nfernoedge/Badge-Preprototype/First Prototype/Initial BOM.xlsx

Schematic # | Rating | Cost | #/board | Part amount for 100 | Cost for 1 | Cost for 100 (10% over) | Notes | Link to part
C1-C3, C6-C7 | 100n | $0.06 | 5 | 500 | $0.29 | $31.90 | Rated 50VDC | https://www.mouser.com/ProductDetail/KYOCERA-AVX/08055C104M4T4A?qs=xMTsDkQFXIy%252BVvJLAuiCrA%3D%3D
C4 | 47n | $0.23 | 1 | 100 | $0.23 | $25.30 | Rated 500VDC, this may be change | https://www.mouser.com/ProductDetail/Vishay-BC-Components/D472M33Z5UL6UJ5R
C5 | 100u | $0.12 | 1 | 100 | $0.12 | $13.53 | Rated 10VDC? | https://www.mouser.com/ProductDetail/Panasonic/EEU-FR1A101B?qs=sGAEpiMZZMvwFf0viD3Y3aIPvi3NCL4PziGmoV7SQrs%3D
D1 | 3v3 | $0.13 | 1 | 100 | $0.13 | $13.97 |  | https://www.mouser.com/ProductDetail/Diotec-Semiconductor/BZT52C3V3?qs=OlC7AqGiEDmtA8GX4QnKtA%3D%3D
D2 | MUR160 | $0.20 | 1 | 100 | $0.20 | $21.78 |  | https://www.mouser.com/ProductDetail/Diodes-Incorporated/MUR160?qs=7ctcZc7ShisDdGkSVd5tIw%3D%3D
D3, D4 | 200v | $0.26 | 2 | 200 | $0.52 | $57.20 | Confirm pads | https://www.mouser.com/ProductDetail/Diodes-Incorporated/1SMB5956B-13?qs=uwKJARvjadOTUcHkJGZGig%3D%3D
D5 | 1n4148 | $0.04 | 1 | 100 | $0.04 | $4.95 | Confirm correct diode | https://www.mouser.com/ProductDetail/Diotec-Semiconductor/1N4148?qs=OlC7AqGiEDmWf1%2FPHy84oA%3D%3D
L1 | 10m | $0.22 | 1 | 100 | $0.22 | $24.64 |  | https://www.mouser.com/ProductDetail/Bourns/RLB0812-103KL
Q1 | MPSA44 | $0.24 | 1 | 100 | $0.24 | $26.40 | See second link need heavy advice | https://www.mouser.com/ProductDetail/Diotec-Semiconductor/MPSA44 | https://www.digikey.com/en/products/detail/bourns-inc./RLB0913-103K/6677245
Q2 | BC328 | $0.14 | 1 | 100 | $0.14 | $15.07 |  | https://www.mouser.com/ProductDetail/Diotec-Semiconductor/BC328-16?qs=OlC7AqGiEDnRu3DZnYROLw%3D%3D
Q3 | BC517 | $0.23 | 1 | 100 | $0.23 | $25.08 | Seems rare | https://www.mouser.com/ProductDetail/onsemi-Fairchild/BC517-D74Z?qs=0lQeLiL1qybcgMwglWXoEw%3D%3D
R1 | 3k3 | $0.01 | 1 | 100 | $0.01 | $1.32 | Specs? | https://www.mouser.com/ProductDetail/TE-Connectivity-Holsworthy/CRG0805F3K3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
R2 | 1k5 | $0.04 | 1 | 100 | $0.04 | $3.85 | Specs? | https://www.mouser.com/ProductDetail/Vishay-Dale/CRCW08051K50FKEAHP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
R3 | 15 | $0.06 | 1 | 100 | $0.06 | $6.27 | Specs? | https://www.mouser.com/ProductDetail/ROHM-Semiconductor/SFR10EZPF15R0
R4, R11 | 10k | $0.10 | 2 | 200 | $0.19 | $20.90 | Specs? | https://www.mouser.com/ProductDetail/Vishay-Dale/TNPW080510K0DEEA?qs=dafR6q3Fy0zPpQJxxOiriQ%3D%3D
R5, R10 | 100k | $0.04 | 2 | 200 | $0.08 | $9.02 | Specs? | https://www.mouser.com/ProductDetail/Vishay-Dale/RCC0805100KFKEA
R6-R8 | 1M8 | $0.07 | 3 | 300 | $0.22 | $24.42 | Specs? Voltage? | https://www.mouser.com/ProductDetail/ROHM-Semiconductor/SDR10EZPJ185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
R9 | 220k | $0.07 | 1 | 100 | $0.07 | $8.03 | Specs? | https://www.mouser.com/ProductDetail/Panasonic/ERJ-PB6B2203V?qs=sGAEpiMZZMtlubZbdhIBIMNI7sOfyRuJsIHuhHWPNXI%3D
R12 | 3k9 | $0.07 | 1 | 100 | $0.07 | $8.25 | Specs? | https://www.mouser.com/ProductDetail/Panasonic/ERA-6AED392V
U1, U2 | TLC555xP | $0.61 | 2 | 200 | $1.23 | $134.86 | Correct? SMD? Jumper? | https://www.mouser.com/ProductDetail/Texas-Instruments/TLC555CP?qs=gb35HGp1gQKr83Vf%252BmVC1w%3D%3D
Geiger Tube Clips |  | $0.10 | 2 | 200 | $0.20 | $22.44 | Size thoughts? | https://www.mouser.com/ProductDetail/Littelfuse/01110501Z?qs=Ql%252B1sS8nYriZVK%2FyEjYMGg%3D%3D
Geiger Tube | J302 | $19.50 | 1 | 100 | $19.50 | $2145.00 | Shipping Negotiated | https://www.alibaba.com/product-detail/Geiger-Muller-Tube-Glass-case-J302_1600898358443.html
Board | PCBWAY | $8.90 | 1 | 100 | $8.90 | $890.00 | $150 for 4 board; likely to rise with customization
 |  |  | Total Cost: |  | $32.94 | $3534.18
 |  |  | Assumptions: Minimum order of 100 boards for mouser pricing; doesn't include any LED flashing lights, might raise price $1-2, also doesn't include standoff/polycarb/protection
 |  |  |  |  | Without Tubes | $1389.18
