nfernoedge/Badge-Preprototype/First Prototype/schematic.pdf

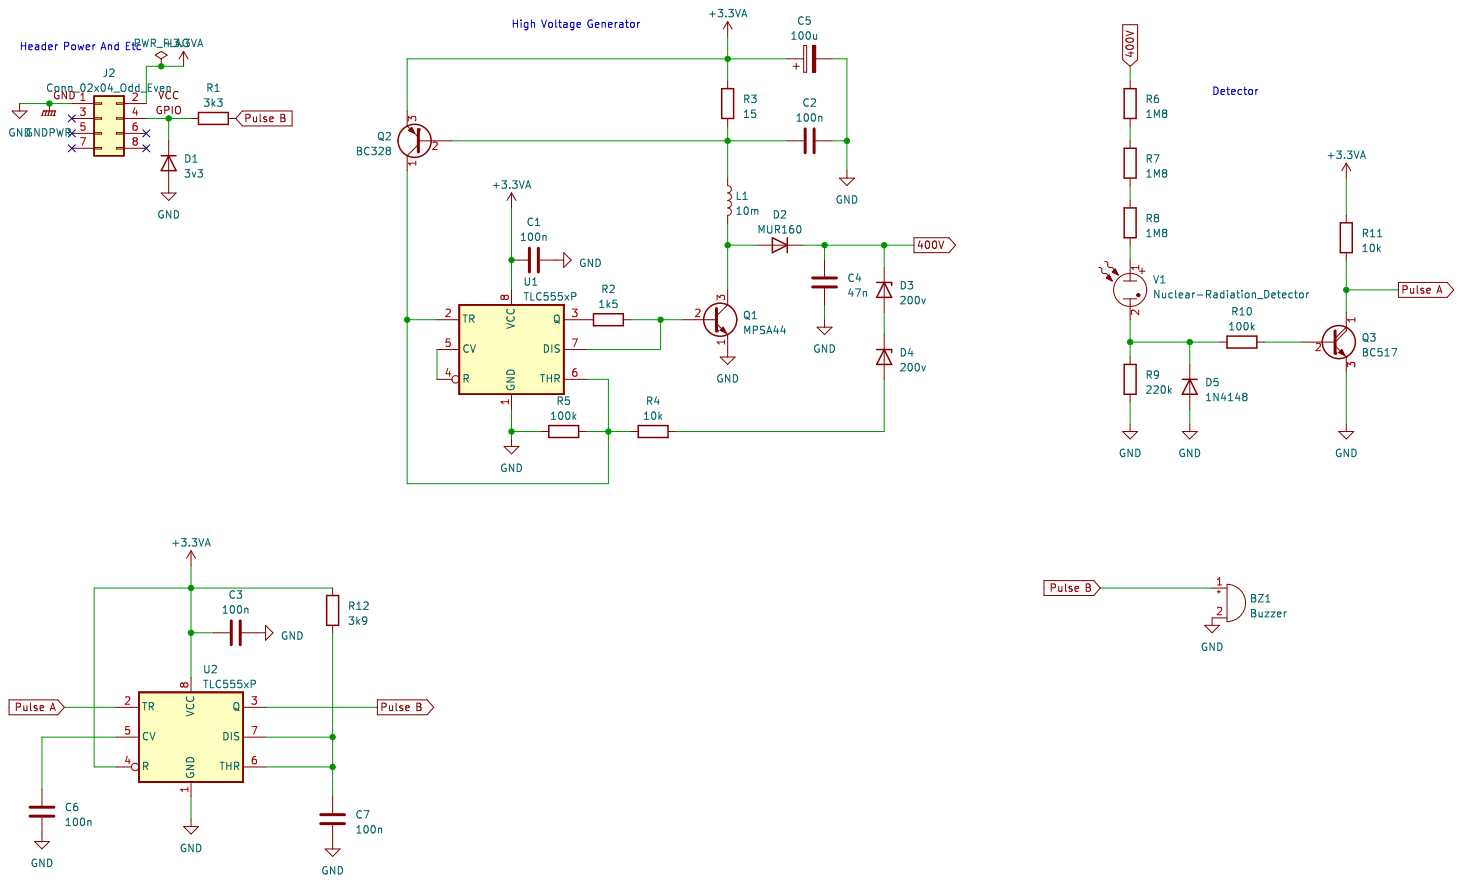
[picture p2: page 1]
