nfernoedge/Badge-Preprototype/First Prototype/Initial Build/Initial Build.kicad_pcb

## KiCad design First Prototype/Initial Build/Initial Build.kicad_pcb (2023-10-23)

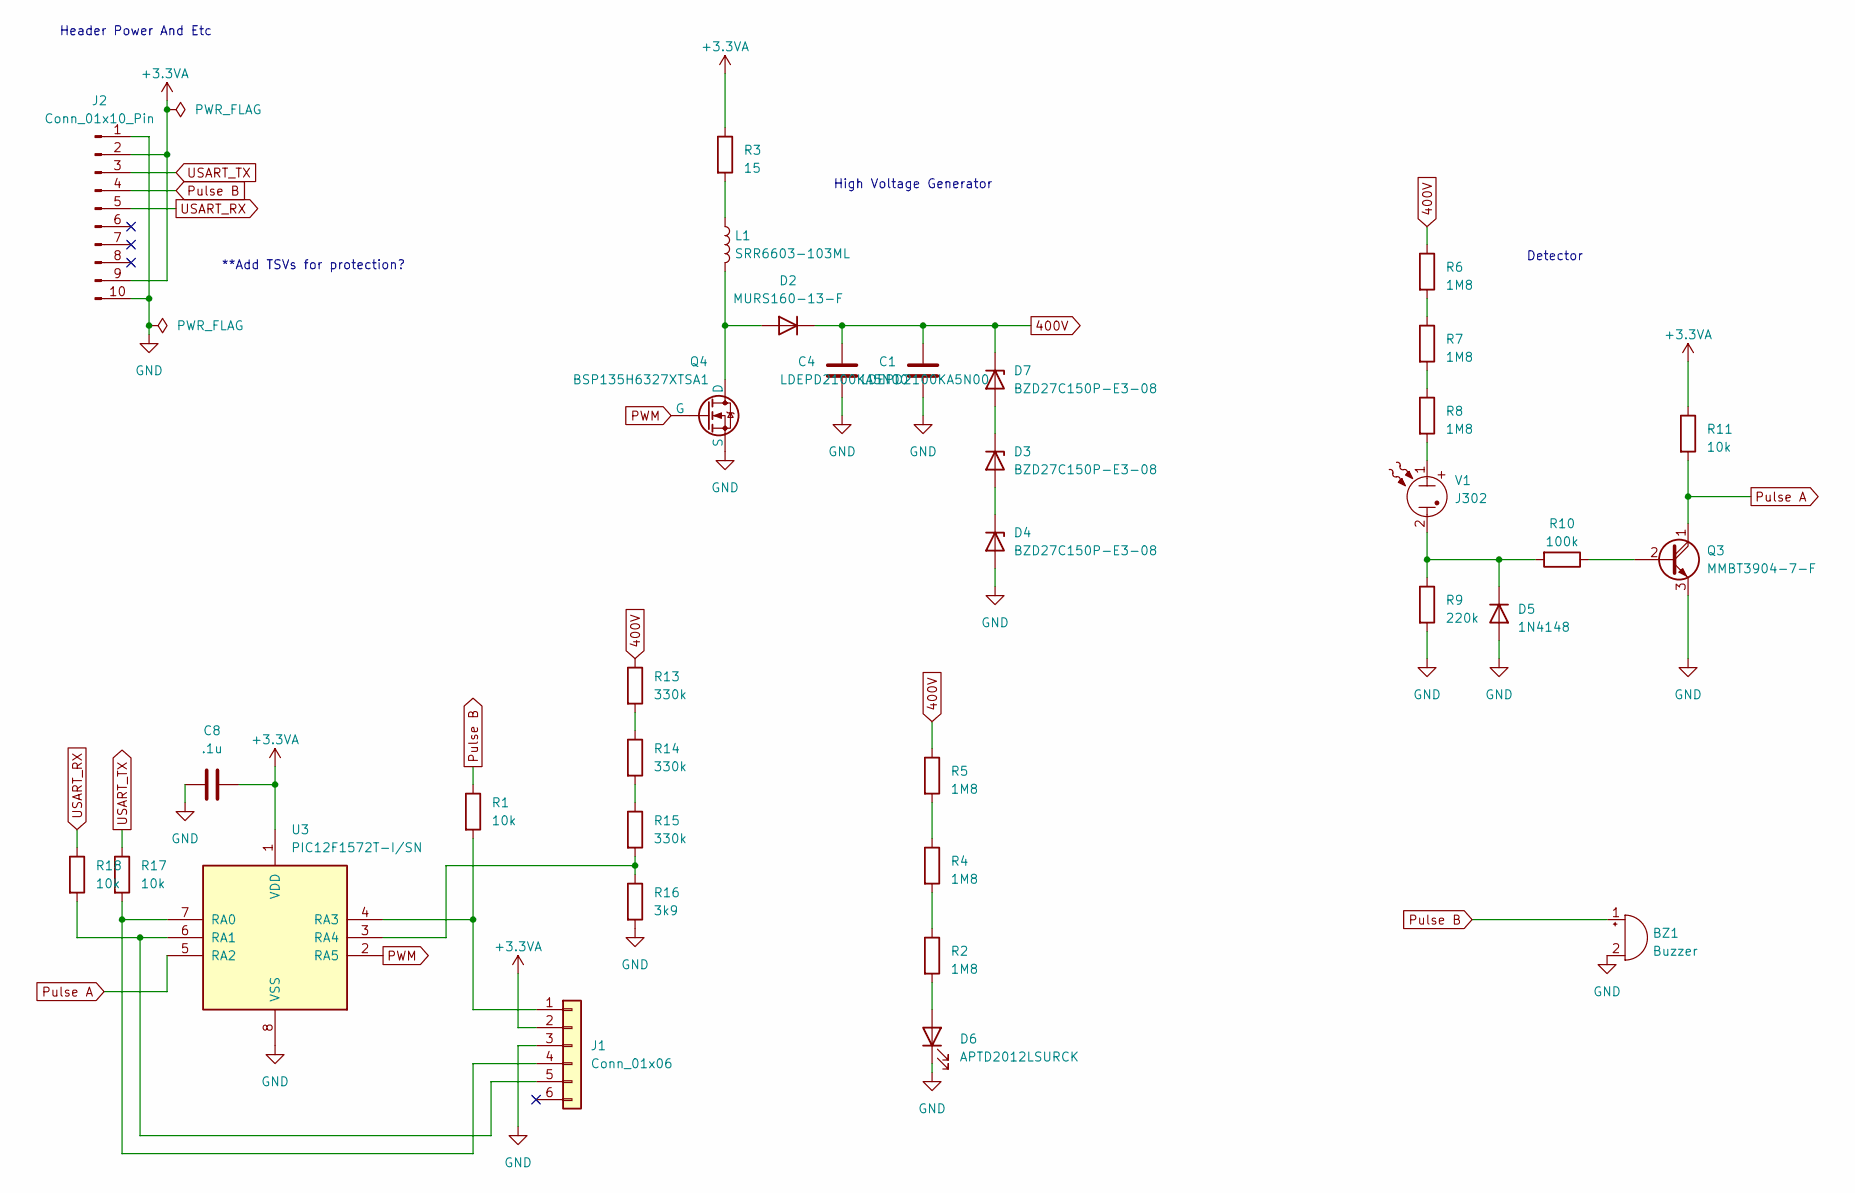
[picture p3: schematic Initial Build.kicad_sch]

Parts:
BZ1: Buzzer; Buzzer_12x9.5RM7.6
C1, C4: LDEPD2100KA5N00; C_2220_5650Metric_Pad1.97x5.40mm_HandSolder
C8: .1u; C_0805_2012Metric_Pad1.18x1.45mm_HandSolder
D2: MURS160-13-F; D_SMB_Handsoldering
D3, D4, D7: BZD27C150P-E3-08; D_SMF
D5: 1N4148; D_SMB-SMC_Universal_Handsoldering
D6: APTD2012LSURCK; LED_0805_2012Metric_Pad1.15x1.40mm_HandSolder
J1: Conn_01x06; PinHeader_1x06_P2.54mm_Vertical
J2: Conn_01x10_Pin; PinHeader_2x05_P2.54mm_Vertical
L1: SRR6603-103ML; L_Bourns_SRP7028A_7.3x6.6mm
Q3: MMBT3904-7-F; SOT-23-3
Q4: BSP135H6327XTSA1; SOT-223
R1, R11, R17, R18: 10k; R_1206_3216Metric_Pad1.30x1.75mm_HandSolder
R2, R4, R5, R6, R7, R8: 1M8; R_1206_3216Metric_Pad1.30x1.75mm_HandSolder
R3: 15; R_1206_3216Metric_Pad1.30x1.75mm_HandSolder
R9: 220k; R_1206_3216Metric_Pad1.30x1.75mm_HandSolder
R10: 100k; R_1206_3216Metric_Pad1.30x1.75mm_HandSolder
R13, R14, R15: 330k; R_1206_3216Metric_Pad1.30x1.75mm_HandSolder
R16: 3k9; R_1206_3216Metric_Pad1.30x1.75mm_HandSolder
U3: PIC12F1572T-I/SN; SOIC-8_3.9x4.9mm_P1.27mm
V1: J302; Geiger_Clips

Connections:
400V: C1.2, C4.2, D2.1 (K), D7.1 (K), R5.1, R6.1, R13.1
+3.3VA: C8.1, J1.2, J2.2, J2.9, R3.1, R11.1, U3.1 (VDD)
GND: BZ1.2 (+), C1.1, C4.1, C8.2, D4.2 (A), D5.2 (A), D6.1 (K), J1.3, J2.1, J2.10, Q3.3 (E), Q4.3 (S), R9.2, R16.2, U3.8 (VSS)
unnamed: D2.2 (A), L1.2, Q4.1 (D)
unnamed: D3.2 (A), D4.1 (K)
unnamed: D3.1 (K), D7.2 (A)
unnamed: D5.1 (K), R9.1, R10.2, V1.2
unnamed: D6.2 (A), R2.2
unnamed: J1.1, R1.2, U3.4 (RA3)
unnamed: J1.4, R17.2, U3.7 (RA0)
unnamed: J1.5, R18.2, U3.6 (RA1)
unnamed: L1.1, R3.2
unnamed: Q3.2 (B), R10.1
unnamed: R2.1, R4.2
unnamed: R4.1, R5.2
unnamed: R6.2, R7.1
unnamed: R7.2, R8.1
unnamed: R8.2, V1.1
unnamed: R13.2, R14.1
unnamed: R14.2, R15.1
unnamed: R15.2, R16.1, U3.3 (RA4)
PWM: Q4.2 (G), U3.2 (RA5)
Pulse A: Q3.1 (C), R11.2, U3.5 (RA2)
Pulse B: BZ1.1 (-), J2.4, R1.1
USART_RX: J2.5, R18.1
USART_TX: J2.3, R17.1

Notes on the sheet:
High Voltage Generator
**Add TSVs for protection?
Detector
Header Power And Etc

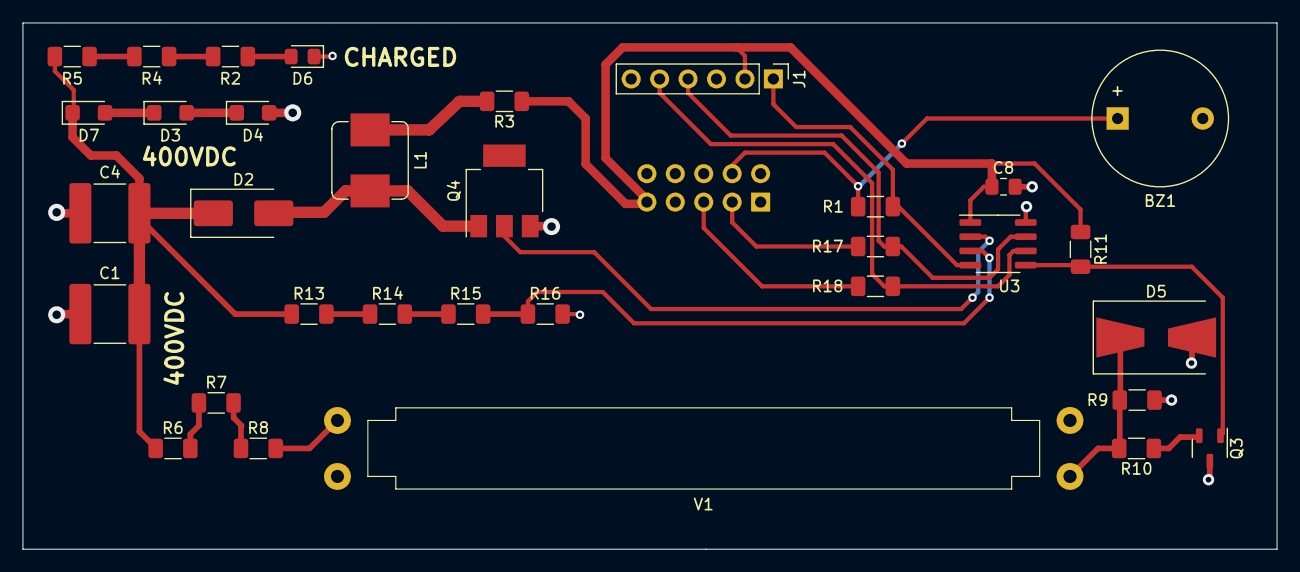
[picture p4: board Initial Build.kicad_pcb from above]

Board: 2 copper layers, 112.0 x 47.0 mm, 34 parts (1 on the bottom side), 26 nets.
