nfernoedge/Badge-Preprototype/LCDBadge/kicad/lcdbadge/Prod_Badge_2024.kicad_pcb

## KiCad design LCDBadge/kicad/lcdbadge/Prod_Badge_2024.kicad_pcb (2024-07-05)

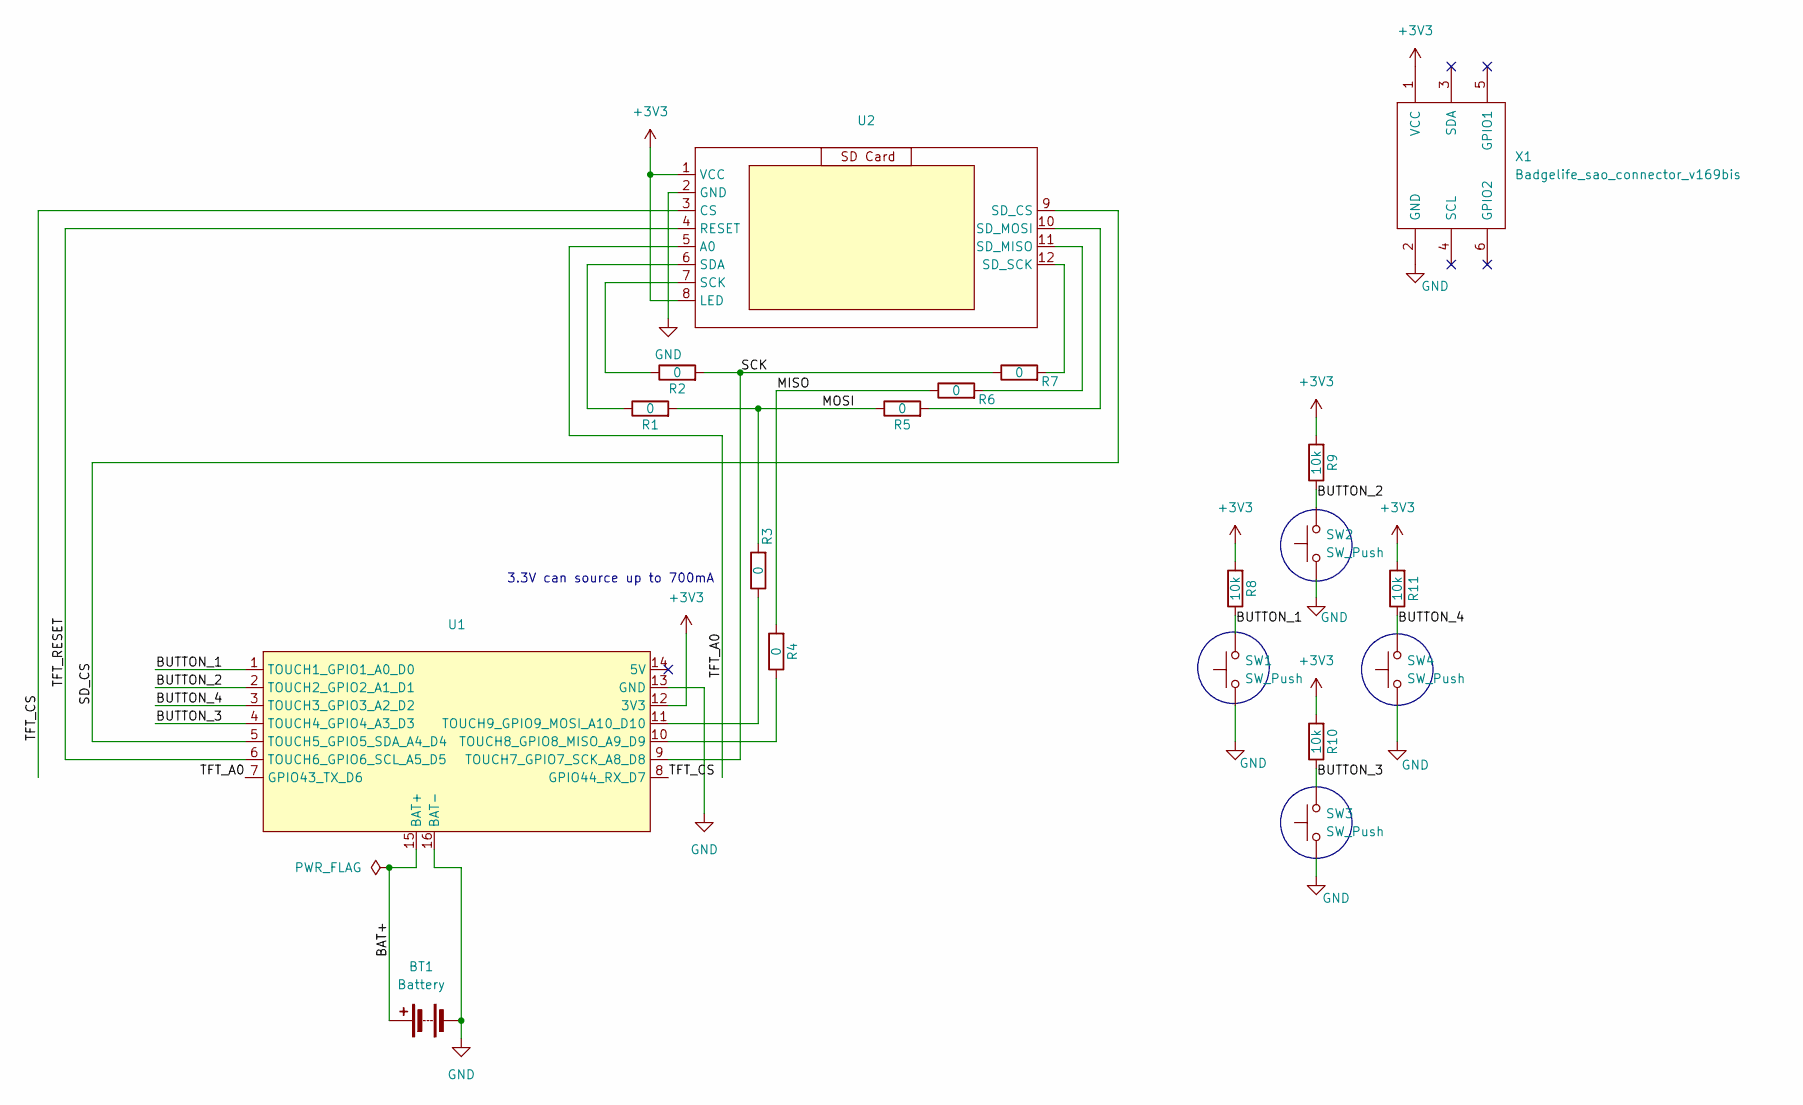
[picture p5: schematic lcdbadge.kicad_sch]

Parts:
BT1: Battery; 12BHC186P1-GR
R1, R2, R3, R4, R5, R6, R7: 0; R_0805_2012Metric_Pad1.20x1.40mm_HandSolder
R8, R9, R10, R11: 10k; R_0805_2012Metric_Pad1.20x1.40mm_HandSolder
SW1, SW2, SW3, SW4: SW_Push; SW_PUSH_6mm_H4.3mm
U1: MOUDLE14P-SMD-2.54-21X17.8MM_BAT
U2: AliExpress_1.8_128x160_ST7735
X1: Badgelife_sao_connector_v169bis; Badgelife-SAOv169-BADGE-2x3

Connections:
+3V3: R8.2, R9.2, R10.2, R11.2, U1.12 (3V3), U2.1 (VCC), U2.8 (LED), X1.1 (VCC)
/BAT+: BT1.1 (+), U1.15 (BAT+)
/BUTTON_1: R8.1, SW1.2, U1.1 (TOUCH1_GPIO1_A0_D0)
/BUTTON_2: R9.1, SW2.2, U1.2 (TOUCH2_GPIO2_A1_D1)
/BUTTON_3: R10.1, SW3.2, U1.4 (TOUCH4_GPIO4_A3_D3)
/BUTTON_4: R11.1, SW4.2, U1.3 (TOUCH3_GPIO3_A2_D2)
/MISO: R4.2, R6.1
/MOSI: R1.2, R3.2, R5.1
/SCK: R2.2, R7.1, U1.9 (TOUCH7_GPIO7_SCK_A8_D8)
/SD_CS: U1.5 (TOUCH5_GPIO5_SDA_A4_D4), U2.9 (SD_CS)
/TFT_A0: U1.7 (GPIO43_TX_D6), U2.5 (A0)
/TFT_CS: U1.8 (GPIO44_RX_D7), U2.3 (CS)
/TFT_RESET: U1.6 (TOUCH6_GPIO6_SCL_A5_D5), U2.4 (RESET)
GND: BT1.2 (-), SW1.1, SW2.1, SW3.1, SW4.1, U1.13 (GND), U1.16 (BAT-), U2.2 (GND), X1.2 (GND)
unnamed: R4.1, U1.10 (TOUCH8_GPIO8_MISO_A9_D9)
unnamed: R3.1, U1.11 (TOUCH9_GPIO9_MOSI_A10_D10)
unnamed: R2.1, U2.7 (SCK)
unnamed: R1.1, U2.6 (SDA)
unnamed: R6.2, U2.11 (SD_MISO)
unnamed: R5.2, U2.10 (SD_MOSI)
unnamed: R7.2, U2.12 (SD_SCK)

Notes on the sheet:
3.3V can source up to 700mA

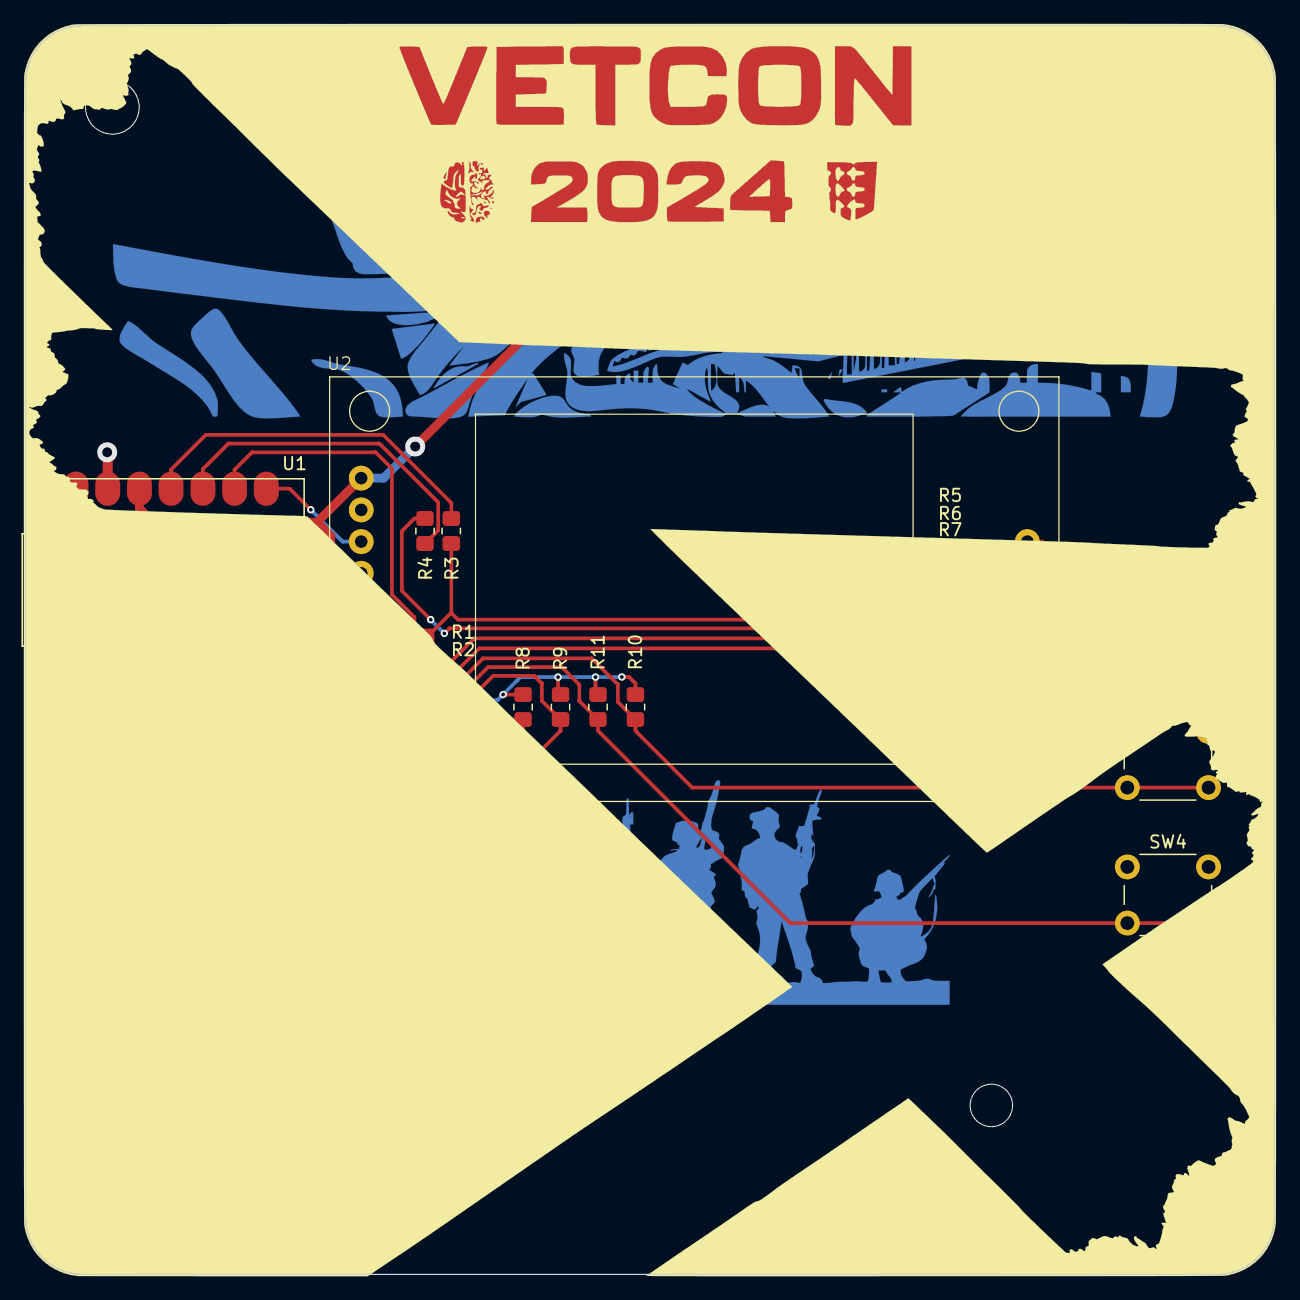
[picture p6: board Prod_Badge_2024.kicad_pcb from above]

Board: 2 copper layers, 100.0 x 100.0 mm, 19 parts (1 on the bottom side), 21 nets.
