nfernoedge/Badge-Preprototype/(commit log)

2023-09-01 Add files via upload
    Fixing excel formula
    [Initial BOM.xlsx]
2023-09-18 added pic
    [Initial Build.kicad_sch]
2023-09-22 removed non-pic related components added indicator for 400v
    [Initial Build.kicad_sch]
2023-09-25 updated tube fp began routing
    [Initial Build.kicad_pcb, Initial Build.kicad_sch]
2023-09-25 finished routing
    [Initial Build.kicad_pcb]
2024-07-04 pushing schematic and initial pcb
    [Button_Calcs.xls, Prod_Badge_2024.kicad_pcb, lcdbadge.kicad_pcb, lcdbadge.kicad_sch]
2024-07-05 routed board updated button changed from route to large vias for module
    [Prod_Badge_2024.kicad_pcb, XIAO-ESP32S3 v2.step, lcdbadge.kicad_pcb, lcdbadge.kicad_sch]
2024-07-05 rotated esp moved resistors away from sd card holder
    [Initial Build.kicad_sch, Prod_Badge_2024.kicad_pcb, XIAO-ESP32S3 v2.step, lcdbadge.kicad_sch]
2024-08-05 added both SD error detection, and BSOD capabilities.
    [main.cpp]
2024-08-19 Updated to be the correct screen and added first boot check for flash.
    [main.cpp]
